brunostjohn/button-midi-thing/pics/back.jpg

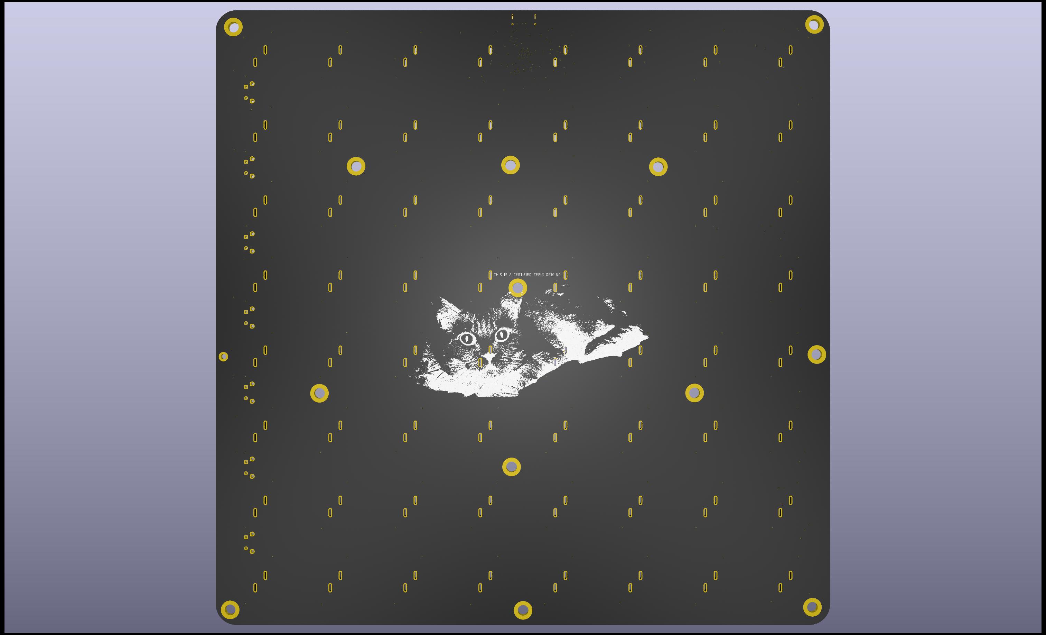
pics/back.jpg
