brunostjohn/button-midi-thing/pics/front.jpg

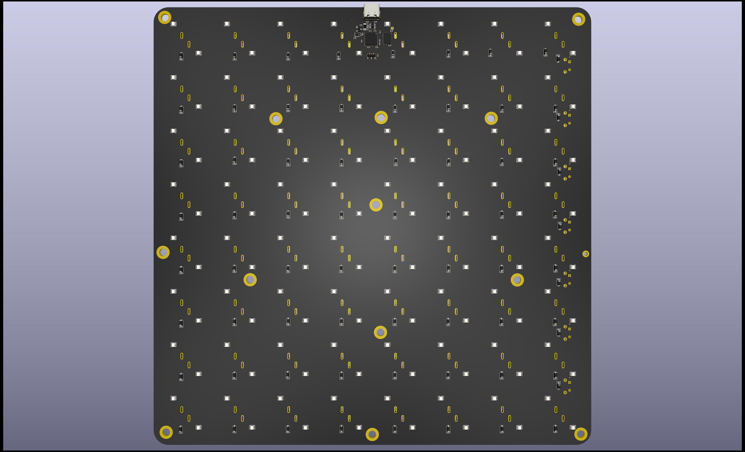
pics/front.jpg
