brunostjohn/button-midi-thing/button-thing-fw/palettes/README.md

# Palettes

These are used to generate LED colour values. All of them are made by Kaskobi and taken from the [Kaskobi website](https://kaskobi.com/palettes).
