brunostjohn/button-midi-thing/(list of files, cad)

Other CAD files:
Button MIDI Controller.step
models/WS2812B-2020--3DModel-STEP-269445.STEP
svgs/breadboardbutton v4.step
symbols_footprints/MPB06-1C33-R-SMT-TR/MPB06-1C33-R-SMT-TR.step
symbols_footprints/TS11-674-120-BK-100-RA-D/TS11-674-120-BK-100-RA-D.step
symbols_footprints/USBLC6-2SC6/USBLC6-2SC6.step
symbols_footprints/W25Q16JVZPIQ/W25Q16JVZPIQ.step
symbols_footprints/2340901-1/2340901-1.step
