brunostjohn/button-midi-thing/Button MIDI Controller.kicad_pcb

## KiCad design Button MIDI Controller.kicad_pcb (2025-05-30)

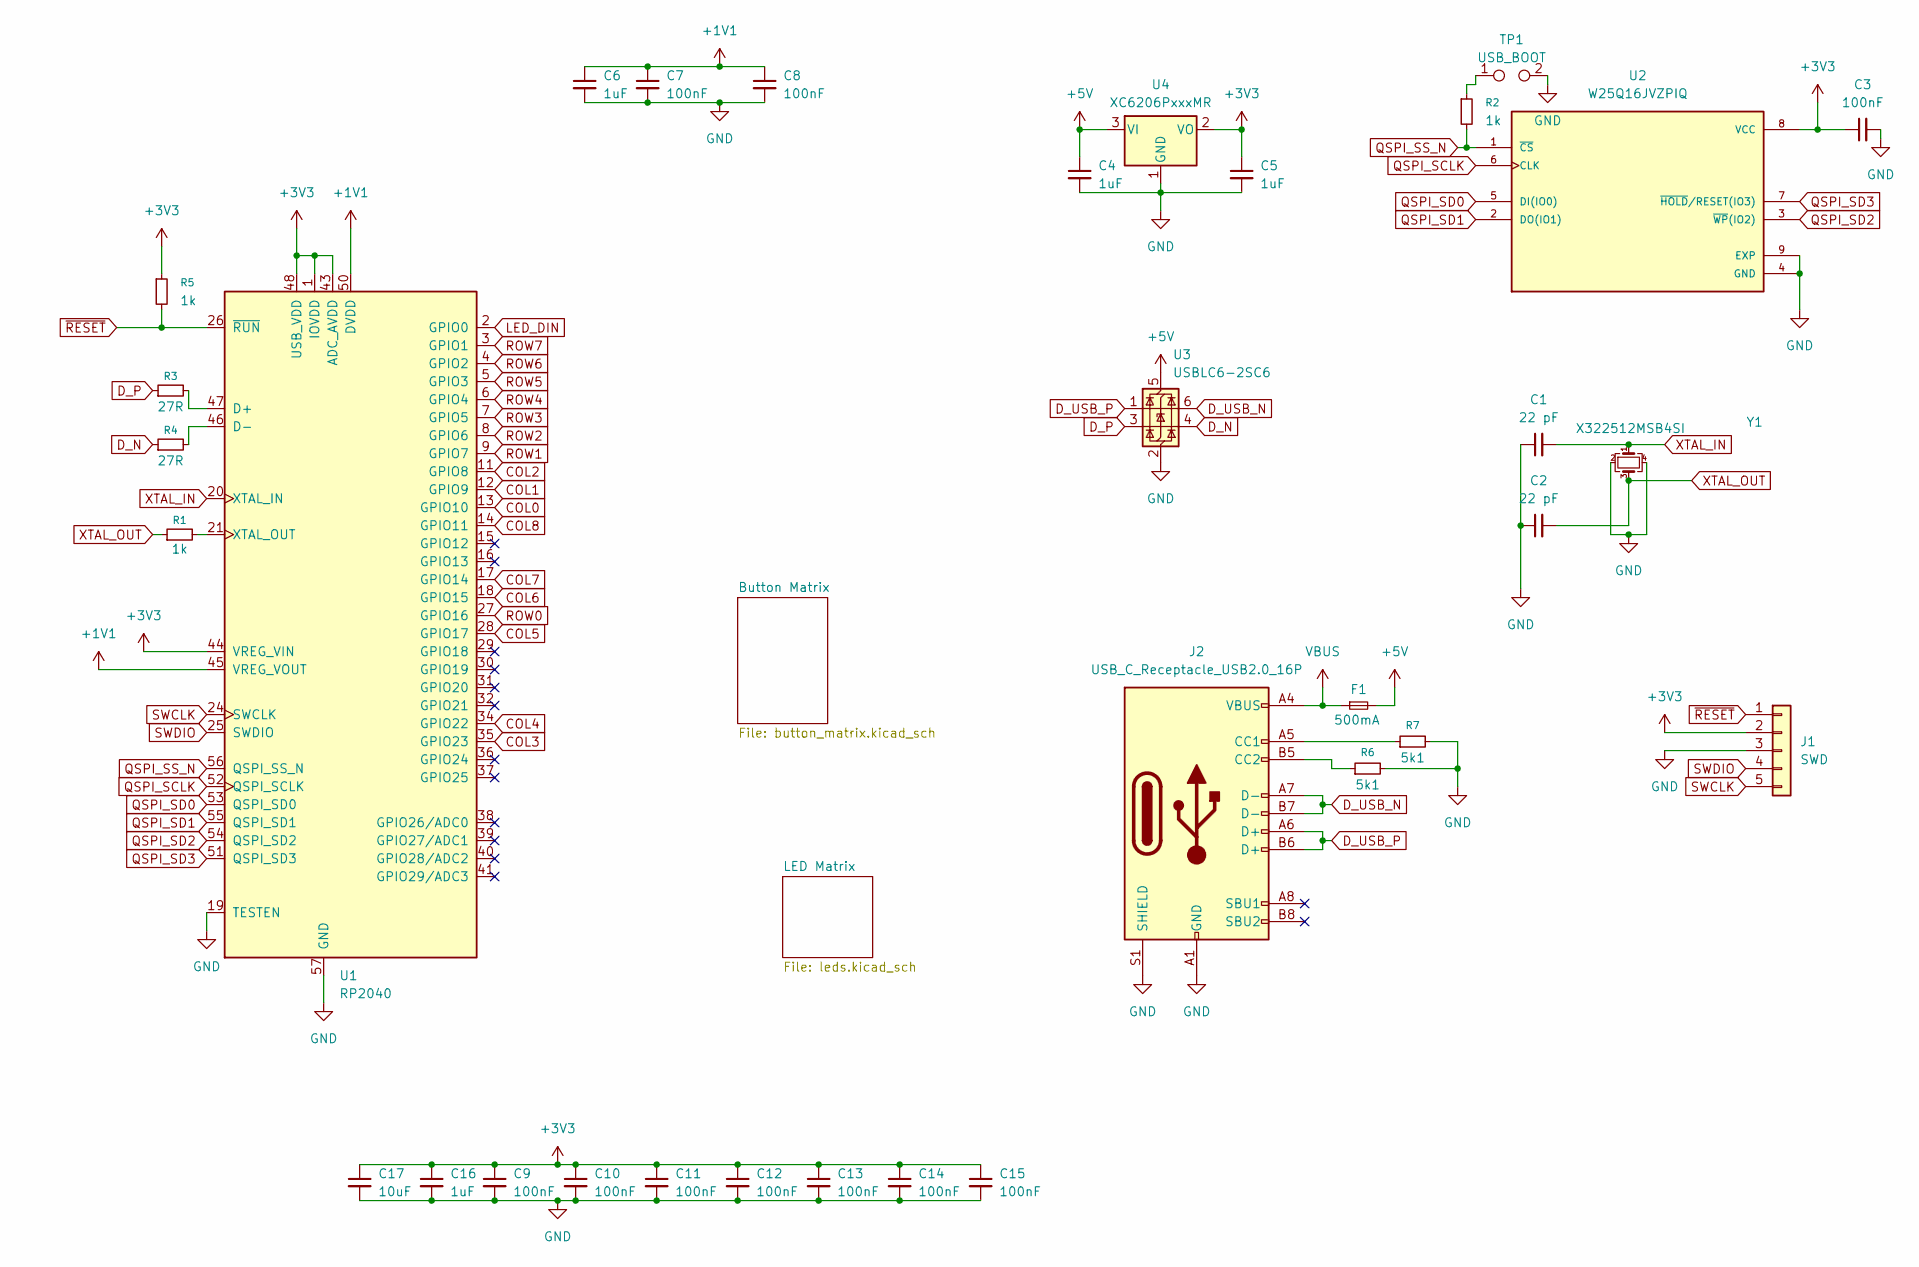
[picture p3: schematic Button MIDI Controller.kicad_sch]

Parts:
C1, C2: 22 pF; C_0402_1005Metric-notxt
C3, C7, C8, C9, C10, C11, C12, C13, C14, C15: 100nF; C_0402_1005Metric-notxt
C4, C5, C6, C16: 1uF; C_0402_1005Metric-notxt
C17: 10uF; C_0402_1005Metric-notxt
F1: 500mA; Fuse_0402_1005Metric-notxt
J1: SWD; PinHeader_1x05_P1.00mm_Vertical_SMD_Pin1Right-notxt
J2: USB_C_Receptacle_USB2.0_16P; USB_C_Receptacle_G-Switch_GT-USB-7025-notxt
R1, R2, R5: 1k; R_0402_1005Metric-notext
R3, R4: 27R; R_0402_1005Metric-notext
R6, R7: 5k1; R_0402_1005Metric-notext
TP1: USB_BOOT; TestPoint_Pad_1.0x1.0mm-notxt
U1: RP2040; RP2040-QFN-56-notext
U2: W25Q16JVZPIQ; SON127P500X600X80-9N-notxt
U3: USBLC6-2SC6; SOT-23-6-notxt
U4: XC6206PxxxMR; SOT-23-3-notxt
Y1: X322512MSB4SI; Crystal_SMD_2016-4Pin_2.0x1.6mm-notxt

Connections:
+1V1: C6.1, C7.1, C8.1, U1.23 (DVDD), U1.45 (VREG_VOUT), U1.50 (DVDD)
+3V3: C3.1, C5.1, C9.1, C10.1, C11.1, C12.1, C13.1, C14.1, C15.1, C16.1, C17.1, J1.2, R5.1, U1.1 (IOVDD), U1.10 (IOVDD), U1.22 (IOVDD), U1.33 (IOVDD), U1.42 (IOVDD), U1.43 (ADC_AVDD), U1.44 (VREG_VIN), U1.48 (USB_VDD), U1.49 (IOVDD), U2.8 (VCC), U4.2 (VO)
+5V: C4.1, F1.2, U3.5 (VBUS), U4.3 (VI); also elsewhere on the board
COL0: U1.13 (GPIO10); also elsewhere on the board
COL1: U1.12 (GPIO9); also elsewhere on the board
COL2: U1.11 (GPIO8); also elsewhere on the board
COL3: U1.35 (GPIO23); also elsewhere on the board
COL4: U1.34 (GPIO22); also elsewhere on the board
COL5: U1.28 (GPIO17); also elsewhere on the board
COL6: U1.18 (GPIO15); also elsewhere on the board
COL7: U1.17 (GPIO14); also elsewhere on the board
COL8: U1.14 (GPIO11); also elsewhere on the board
D_N: R4.1, U3.4 (I/O2)
D_P: R3.1, U3.3 (I/O2)
D_USB_N: J2.A7 (D-), J2.B7 (D-), U3.6 (I/O1)
D_USB_P: J2.A6 (D+), J2.B6 (D+), U3.1 (I/O1)
GND: C1.1, C2.1, C3.2, C4.2, C5.2, C6.2, C7.2, C8.2, C9.2, C10.2, C11.2, C12.2, C13.2, C14.2, C15.2, C16.2, C17.2, J1.3, J2.A1 (GND), J2.A12 (GND), J2.B1 (GND), J2.B12 (GND), J2.S1 (SHIELD), R6.2, R7.2, TP1.2, U1.19 (TESTEN), U1.57 (GND), U2.4 (GND), U2.9 (EXP), U3.2 (GND), U4.1 (GND), Y1.2, Y1.4; also elsewhere on the board
LED_DIN: U1.2 (GPIO0); also elsewhere on the board
unnamed: J2.A5 (CC1), R7.1
unnamed: J2.B5 (CC2), R6.1
unnamed: R2.1, TP1.1
unnamed: R3.2, U1.47 (D+)
unnamed: R4.2, U1.46 (D-)
unnamed: R1.2, U1.21 (XTAL_OUT)
QSPI_SCLK: U1.52 (QSPI_SCLK), U2.6 (CLK)
QSPI_SD0: U1.53 (QSPI_SD0), U2.5 (DI(IO0))
QSPI_SD1: U1.55 (QSPI_SD1), U2.2 (DO(IO1))
QSPI_SD2: U1.54 (QSPI_SD2), U2.3 (~WP(IO2))
QSPI_SD3: U1.51 (QSPI_SD3), U2.7 (~HOLD/RESET(IO3))
QSPI_SS_N: R2.2, U1.56 (QSPI_SS_N), U2.1 (~CS)
ROW0: U1.27 (GPIO16); also elsewhere on the board
ROW1: U1.9 (GPIO7); also elsewhere on the board
ROW2: U1.8 (GPIO6); also elsewhere on the board
ROW3: U1.7 (GPIO5); also elsewhere on the board
ROW4: U1.6 (GPIO4); also elsewhere on the board
ROW5: U1.5 (GPIO3); also elsewhere on the board
ROW6: U1.4 (GPIO2); also elsewhere on the board
ROW7: U1.3 (GPIO1); also elsewhere on the board
SWCLK: J1.5, U1.24 (SWCLK)
SWDIO: J1.4, U1.25 (SWDIO)
VBUS: F1.1, J2.A4 (VBUS), J2.A9 (VBUS), J2.B4 (VBUS), J2.B9 (VBUS)
XTAL_IN: C1.2, U1.20 (XTAL_IN), Y1.1
XTAL_OUT: C2.2, R1.1, Y1.3
~RESET: J1.1, R5.2, U1.26 (~RUN)

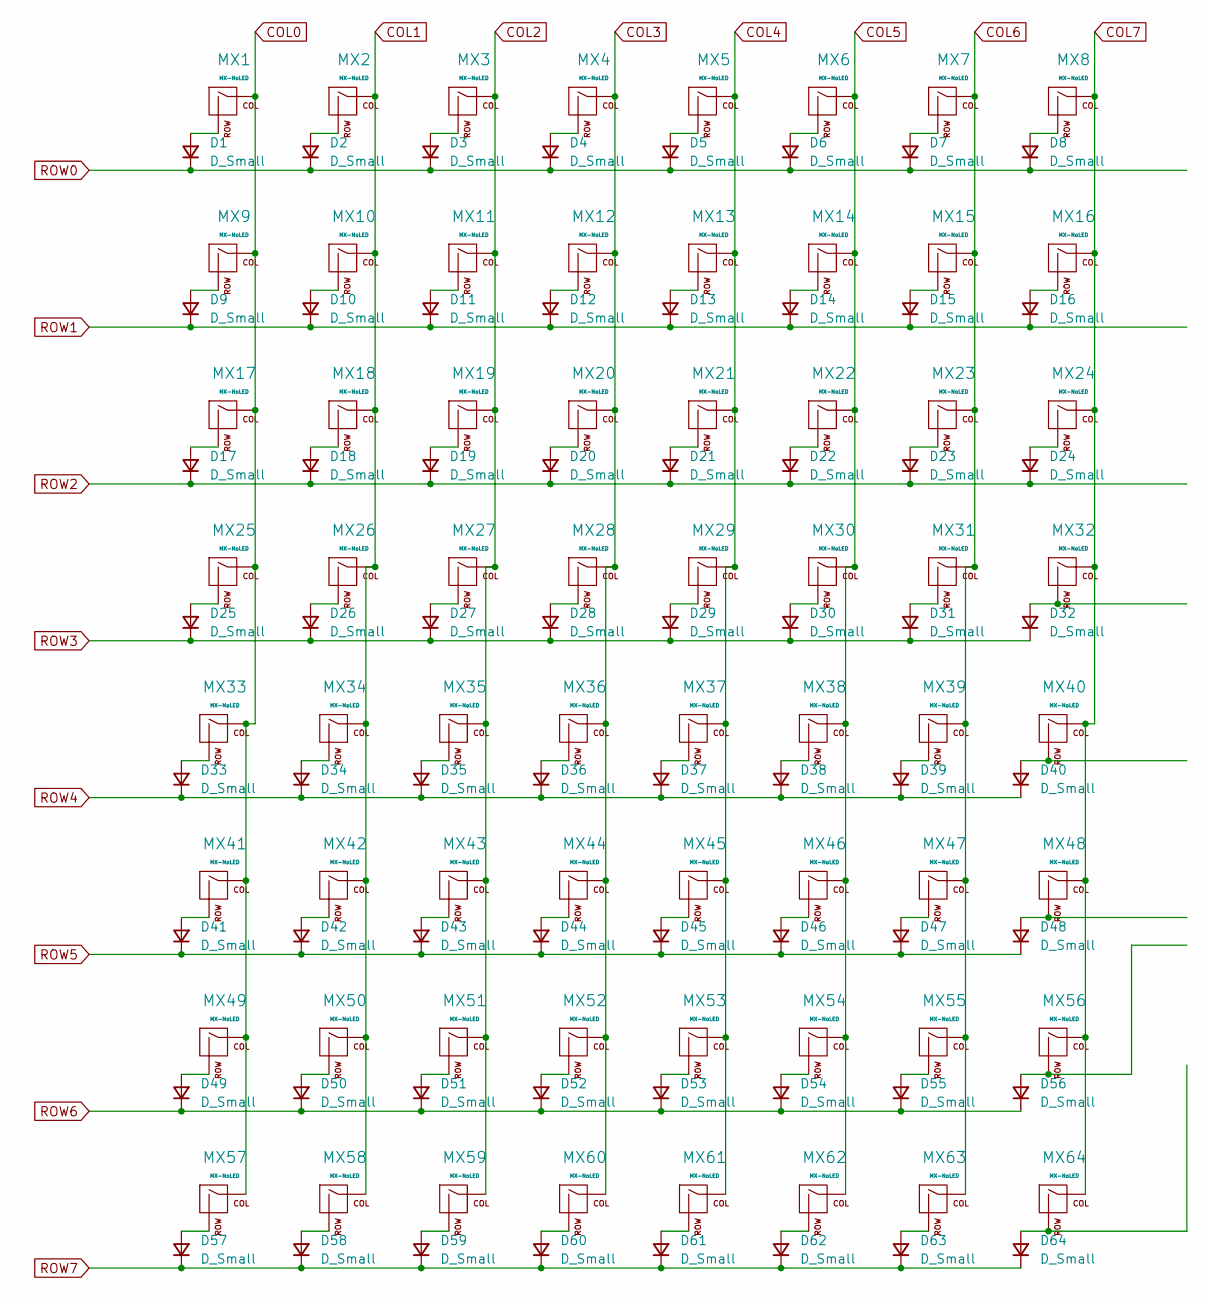
[picture p4: schematic button_matrix.kicad_sch]

Parts:
D1, D2, D3, D4, D5, D6, D7, D8, D9, D10, D11, D12, D13, D14, D15, D16, D17, D18, D19, D20, D21, D22, D23, D24, D25, D26, D27, D28, D29, D30, D31, D32, D33, D34, D35, D36, D37, D38, D39, D40, D41, D42, D43, D44, D45, D46, D47, D48, D49, D50, D51, D52, D53, D54, D55, D56, D57, D58, D59, D60, D61, D62, D63, D64: D_Small; D_0603_1608Metric_NOTXTNOTFUCKD
MX1, MX2, MX3, MX4, MX5, MX6, MX7, MX8, MX9, MX10, MX11, MX12, MX13, MX14, MX15, MX16, MX17, MX18, MX19, MX20, MX21, MX22, MX23, MX24, MX25, MX26, MX27, MX28, MX29, MX30, MX31, MX32, MX33, MX34, MX35, MX36, MX37, MX38, MX39, MX40, MX41, MX42, MX43, MX44, MX45, MX46, MX47, MX48, MX49, MX50, MX51, MX52, MX53, MX54, MX55, MX56, MX57, MX58, MX59, MX60, MX61, MX62, MX63, MX64: MX-NoLED; OBSC-30 SW-68

Connections:
COL0: MX1.1 (COL), MX9.1 (COL), MX17.1 (COL), MX25.1 (COL), MX33.1 (COL), MX41.1 (COL), MX49.1 (COL), MX57.1 (COL); also elsewhere on the board
COL1: MX2.1 (COL), MX10.1 (COL), MX18.1 (COL), MX26.1 (COL), MX34.1 (COL), MX42.1 (COL), MX50.1 (COL), MX58.1 (COL); also elsewhere on the board
COL2: MX3.1 (COL), MX11.1 (COL), MX19.1 (COL), MX27.1 (COL), MX35.1 (COL), MX43.1 (COL), MX51.1 (COL), MX59.1 (COL); also elsewhere on the board
COL3: MX4.1 (COL), MX12.1 (COL), MX20.1 (COL), MX28.1 (COL), MX36.1 (COL), MX44.1 (COL), MX52.1 (COL), MX60.1 (COL); also elsewhere on the board
COL4: MX5.1 (COL), MX13.1 (COL), MX21.1 (COL), MX29.1 (COL), MX37.1 (COL), MX45.1 (COL), MX53.1 (COL), MX61.1 (COL); also elsewhere on the board
COL5: MX6.1 (COL), MX14.1 (COL), MX22.1 (COL), MX30.1 (COL), MX38.1 (COL), MX46.1 (COL), MX54.1 (COL), MX62.1 (COL); also elsewhere on the board
COL6: MX7.1 (COL), MX15.1 (COL), MX23.1 (COL), MX31.1 (COL), MX39.1 (COL), MX47.1 (COL), MX55.1 (COL), MX63.1 (COL); also elsewhere on the board
COL7: MX8.1 (COL), MX16.1 (COL), MX24.1 (COL), MX32.1 (COL), MX40.1 (COL), MX48.1 (COL), MX56.1 (COL), MX64.1 (COL); also elsewhere on the board
unnamed: D1.2 (A), MX1.2 (ROW)
unnamed: D2.2 (A), MX2.2 (ROW)
unnamed: D3.2 (A), MX3.2 (ROW)
unnamed: D4.2 (A), MX4.2 (ROW)
unnamed: D5.2 (A), MX5.2 (ROW)
unnamed: D6.2 (A), MX6.2 (ROW)
unnamed: D7.2 (A), MX7.2 (ROW)
unnamed: D8.2 (A), MX8.2 (ROW)
unnamed: D9.2 (A), MX9.2 (ROW)
unnamed: D10.2 (A), MX10.2 (ROW)
unnamed: D11.2 (A), MX11.2 (ROW)
unnamed: D12.2 (A), MX12.2 (ROW)
unnamed: D13.2 (A), MX13.2 (ROW)
unnamed: D14.2 (A), MX14.2 (ROW)
unnamed: D15.2 (A), MX15.2 (ROW)
unnamed: D16.2 (A), MX16.2 (ROW)
unnamed: D17.2 (A), MX17.2 (ROW)
unnamed: D18.2 (A), MX18.2 (ROW)
unnamed: D19.2 (A), MX19.2 (ROW)
unnamed: D20.2 (A), MX20.2 (ROW)
unnamed: D21.2 (A), MX21.2 (ROW)
unnamed: D22.2 (A), MX22.2 (ROW)
unnamed: D23.2 (A), MX23.2 (ROW)
unnamed: D24.2 (A), MX24.2 (ROW)
unnamed: D25.2 (A), MX25.2 (ROW)
unnamed: D26.2 (A), MX26.2 (ROW)
unnamed: D27.2 (A), MX27.2 (ROW)
unnamed: D28.2 (A), MX28.2 (ROW)
unnamed: D29.2 (A), MX29.2 (ROW)
unnamed: D30.2 (A), MX30.2 (ROW)
unnamed: D31.2 (A), MX31.2 (ROW)
unnamed: D32.2 (A), MX32.2 (ROW)
unnamed: D33.2 (A), MX33.2 (ROW)
unnamed: D34.2 (A), MX34.2 (ROW)
unnamed: D35.2 (A), MX35.2 (ROW)
unnamed: D36.2 (A), MX36.2 (ROW)
unnamed: D37.2 (A), MX37.2 (ROW)
unnamed: D38.2 (A), MX38.2 (ROW)
unnamed: D39.2 (A), MX39.2 (ROW)
unnamed: D40.2 (A), MX40.2 (ROW)
unnamed: D41.2 (A), MX41.2 (ROW)
unnamed: D42.2 (A), MX42.2 (ROW)
unnamed: D43.2 (A), MX43.2 (ROW)
unnamed: D44.2 (A), MX44.2 (ROW)
unnamed: D45.2 (A), MX45.2 (ROW)
unnamed: D46.2 (A), MX46.2 (ROW)
unnamed: D47.2 (A), MX47.2 (ROW)
unnamed: D48.2 (A), MX48.2 (ROW)
unnamed: D49.2 (A), MX49.2 (ROW)
unnamed: D50.2 (A), MX50.2 (ROW)
unnamed: D51.2 (A), MX51.2 (ROW)
unnamed: D52.2 (A), MX52.2 (ROW)
unnamed: D53.2 (A), MX53.2 (ROW)
unnamed: D54.2 (A), MX54.2 (ROW)
unnamed: D55.2 (A), MX55.2 (ROW)
unnamed: D56.2 (A), MX56.2 (ROW)
unnamed: D57.2 (A), MX57.2 (ROW)
unnamed: D58.2 (A), MX58.2 (ROW)
unnamed: D59.2 (A), MX59.2 (ROW)
unnamed: D60.2 (A), MX60.2 (ROW)
unnamed: D61.2 (A), MX61.2 (ROW)
unnamed: D62.2 (A), MX62.2 (ROW)
unnamed: D63.2 (A), MX63.2 (ROW)
unnamed: D64.2 (A), MX64.2 (ROW)
ROW0: D1.1 (K), D2.1 (K), D3.1 (K), D4.1 (K), D5.1 (K), D6.1 (K), D7.1 (K), D8.1 (K); also elsewhere on the board
ROW1: D9.1 (K), D10.1 (K), D11.1 (K), D12.1 (K), D13.1 (K), D14.1 (K), D15.1 (K), D16.1 (K); also elsewhere on the board
ROW2: D17.1 (K), D18.1 (K), D19.1 (K), D20.1 (K), D21.1 (K), D22.1 (K), D23.1 (K), D24.1 (K); also elsewhere on the board
ROW3: D25.1 (K), D26.1 (K), D27.1 (K), D28.1 (K), D29.1 (K), D30.1 (K), D31.1 (K), D32.1 (K); also elsewhere on the board
ROW4: D33.1 (K), D34.1 (K), D35.1 (K), D36.1 (K), D37.1 (K), D38.1 (K), D39.1 (K), D40.1 (K); also elsewhere on the board
ROW5: D41.1 (K), D42.1 (K), D43.1 (K), D44.1 (K), D45.1 (K), D46.1 (K), D47.1 (K), D48.1 (K); also elsewhere on the board
ROW6: D49.1 (K), D50.1 (K), D51.1 (K), D52.1 (K), D53.1 (K), D54.1 (K), D55.1 (K), D56.1 (K); also elsewhere on the board
ROW7: D57.1 (K), D58.1 (K), D59.1 (K), D60.1 (K), D61.1 (K), D62.1 (K), D63.1 (K), D64.1 (K); also elsewhere on the board

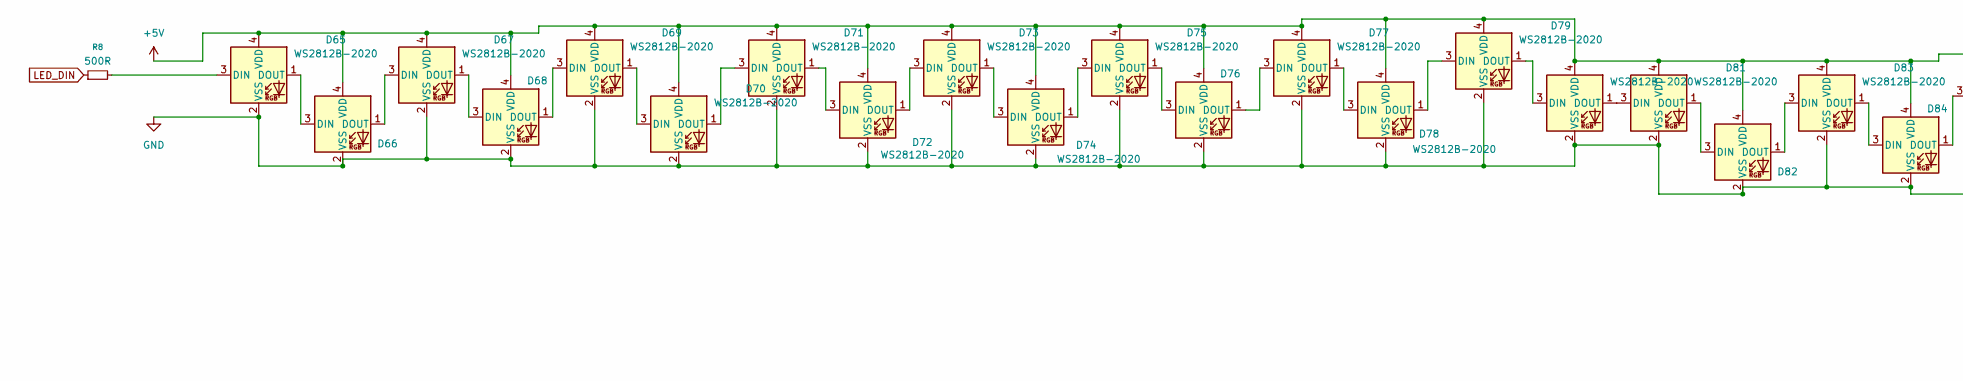
[picture p5: schematic leds.kicad_sch, part in row 1, column 1]

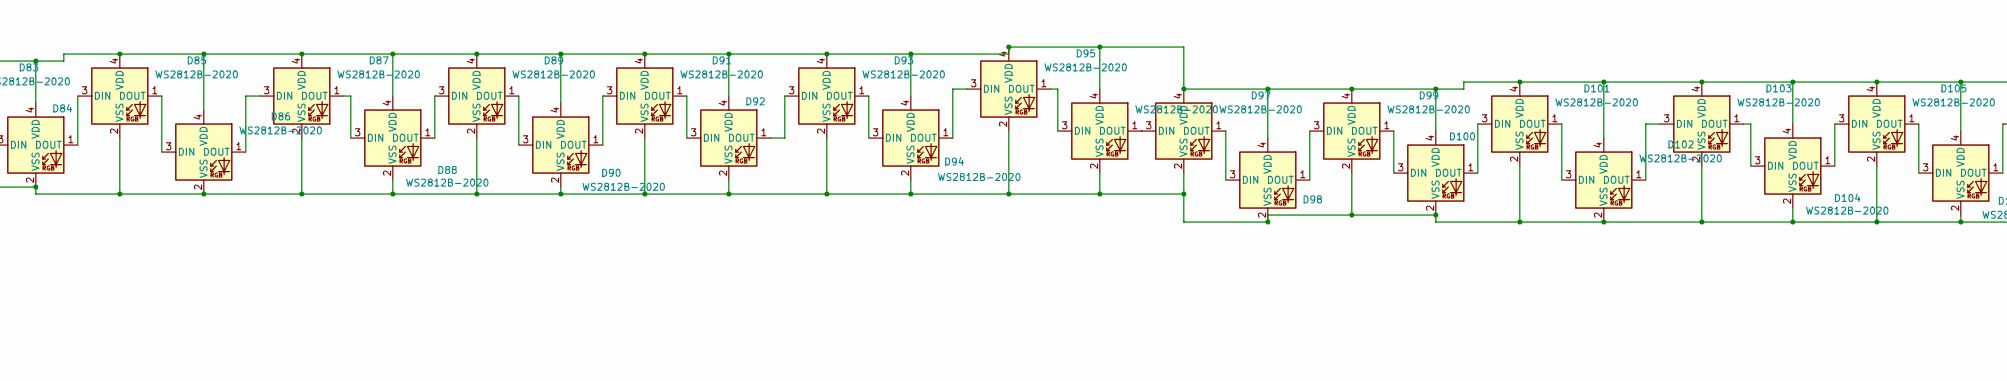
[picture p6: schematic leds.kicad_sch, part in row 1, column 2]

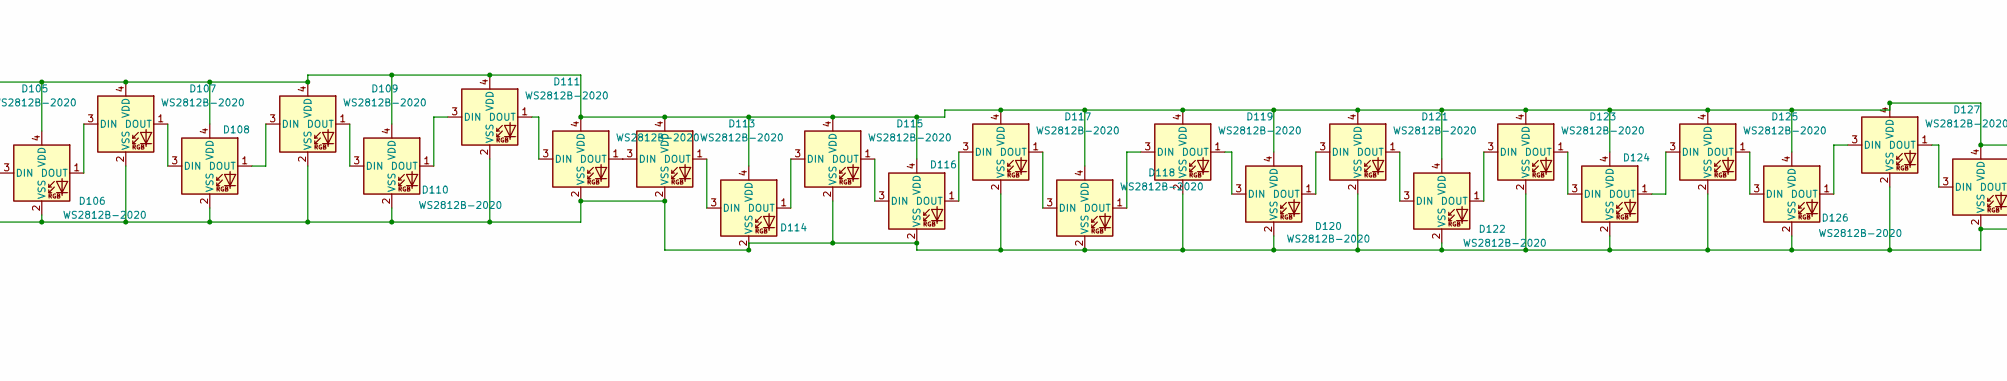
[picture p7: schematic leds.kicad_sch, part in row 1, column 3]

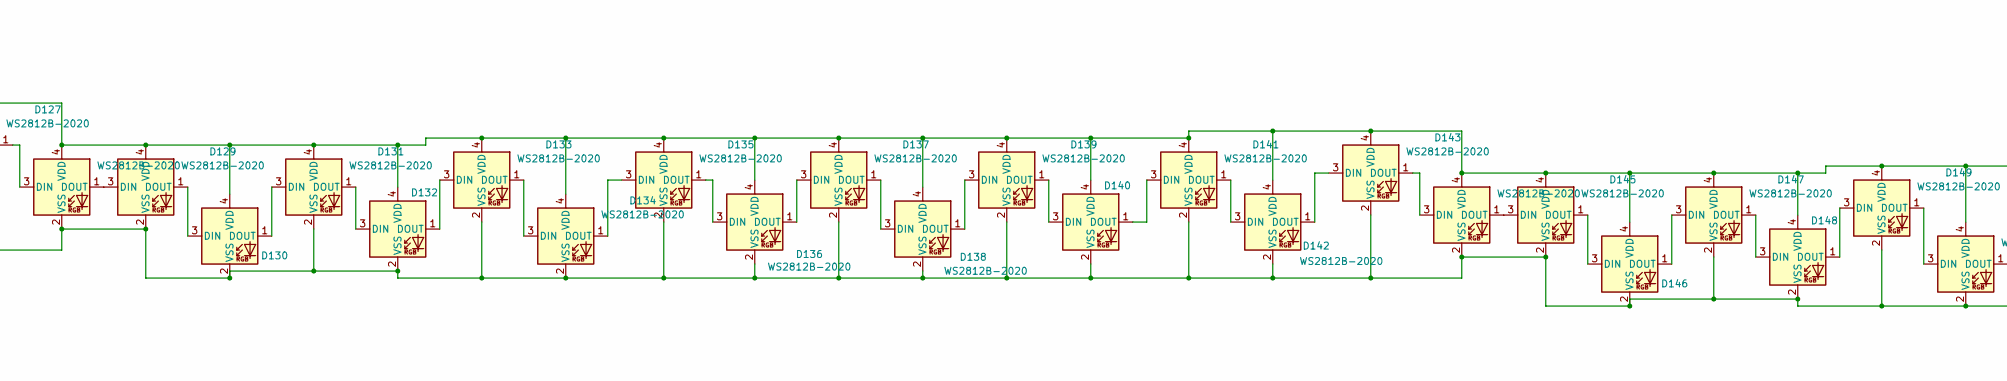
[picture p8: schematic leds.kicad_sch, part in row 1, column 4]

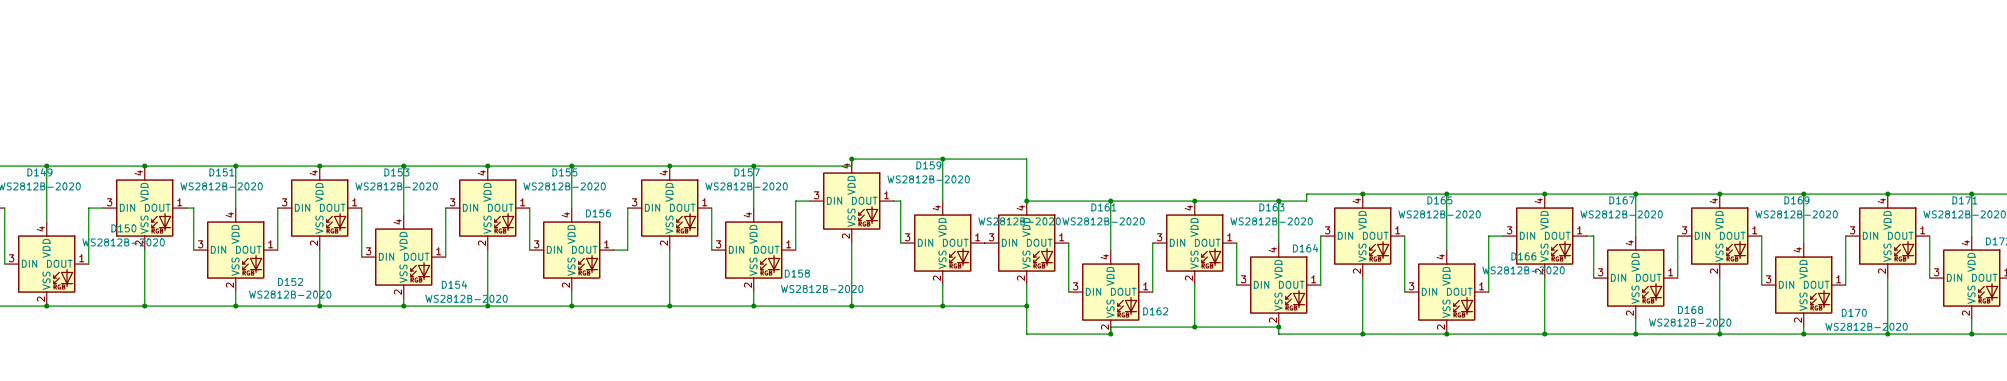
[picture p9: schematic leds.kicad_sch, part in row 1, column 5]

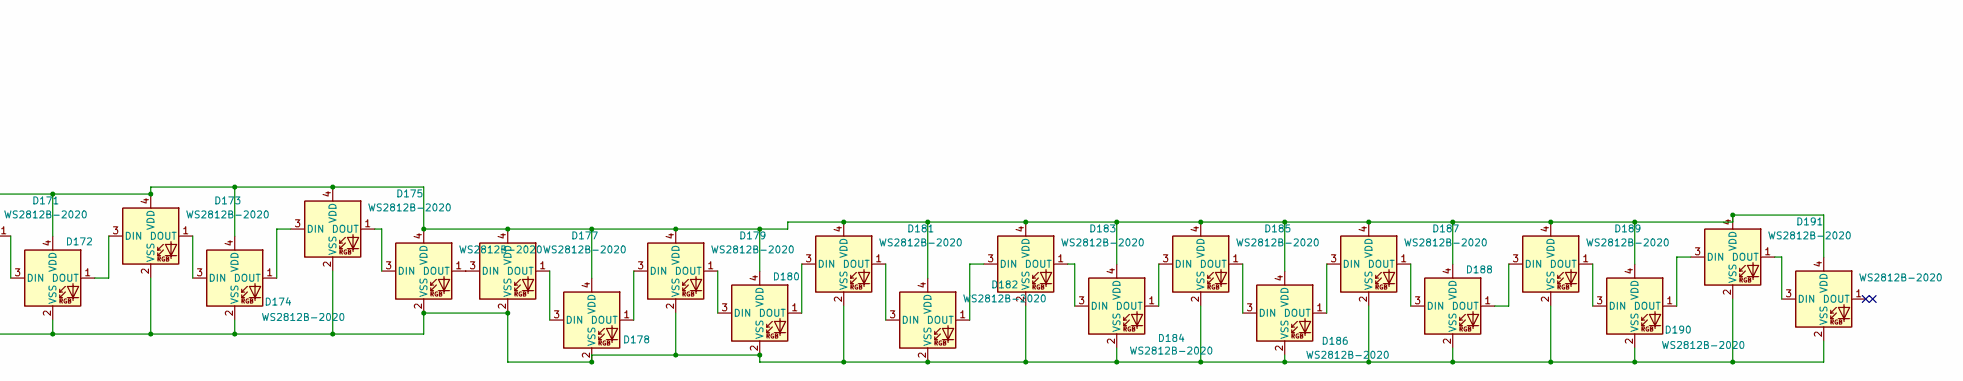
[picture p10: schematic leds.kicad_sch, part in row 1, column 6]

Parts:
D65, D66, D67, D68, D69, D70, D71, D72, D73, D74, D75, D76, D77, D78, D79, D80, D81, D82, D83, D84, D85, D86, D87, D88, D89, D90, D91, D92, D93, D94, D95, D96, D97, D98, D99, D100, D101, D102, D103, D104, D105, D106, D107, D108, D109, D110, D111, D112, D113, D114, D115, D116, D117, D118, D119, D120, D121, D122, D123, D124, D125, D126, D127, D128, D129, D130, D131, D132, D133, D134, D135, D136, D137, D138, D139, D140, D141, D142, D143, D144, D145, D146, D147, D148, D149, D150, D151, D152, D153, D154, D155, D156, D157, D158, D159, D160, D161, D162, D163, D164, D165, D166, D167, D168, D169, D170, D171, D172, D173, D174, D175, D176, D177, D178, D179, D180, D181, D182, D183, D184, D185, D186, D187, D188, D189, D190, D191, D192: WS2812B-2020; LED_WS2812B-2020_PLCC4_2.0x2.0mm-notext
R8: 500R; R_0402_1005Metric-notext

Connections:
+5V: D65.4 (VDD), D66.4 (VDD), D67.4 (VDD), D68.4 (VDD), D69.4 (VDD), D70.4 (VDD), D71.4 (VDD), D72.4 (VDD), D73.4 (VDD), D74.4 (VDD), D75.4 (VDD), D76.4 (VDD), D77.4 (VDD), D78.4 (VDD), D79.4 (VDD), D80.4 (VDD), D81.4 (VDD), D82.4 (VDD), D83.4 (VDD), D84.4 (VDD), D85.4 (VDD), D86.4 (VDD), D87.4 (VDD), D88.4 (VDD), D89.4 (VDD), D90.4 (VDD), D91.4 (VDD), D92.4 (VDD), D93.4 (VDD), D94.4 (VDD), D95.4 (VDD), D96.4 (VDD), D97.4 (VDD), D98.4 (VDD), D99.4 (VDD), D100.4 (VDD), D101.4 (VDD), D102.4 (VDD), D103.4 (VDD), D104.4 (VDD), D105.4 (VDD), D106.4 (VDD), D107.4 (VDD), D108.4 (VDD), D109.4 (VDD), D110.4 (VDD), D111.4 (VDD), D112.4 (VDD), D113.4 (VDD), D114.4 (VDD), D115.4 (VDD), D116.4 (VDD), D117.4 (VDD), D118.4 (VDD), D119.4 (VDD), D120.4 (VDD), D121.4 (VDD), D122.4 (VDD), D123.4 (VDD), D124.4 (VDD), D125.4 (VDD), D126.4 (VDD), D127.4 (VDD), D128.4 (VDD), D129.4 (VDD), D130.4 (VDD), D131.4 (VDD), D132.4 (VDD), D133.4 (VDD), D134.4 (VDD), D135.4 (VDD), D136.4 (VDD), D137.4 (VDD), D138.4 (VDD), D139.4 (VDD), D140.4 (VDD), D141.4 (VDD), D142.4 (VDD), D143.4 (VDD), D144.4 (VDD), D145.4 (VDD), D146.4 (VDD), D147.4 (VDD), D148.4 (VDD), D149.4 (VDD), D150.4 (VDD), D151.4 (VDD), D152.4 (VDD), D153.4 (VDD), D154.4 (VDD), D155.4 (VDD), D156.4 (VDD), D157.4 (VDD), D158.4 (VDD), D159.4 (VDD), D160.4 (VDD), D161.4 (VDD), D162.4 (VDD), D163.4 (VDD), D164.4 (VDD), D165.4 (VDD), D166.4 (VDD), D167.4 (VDD), D168.4 (VDD), D169.4 (VDD), D170.4 (VDD), D171.4 (VDD), D172.4 (VDD), D173.4 (VDD), D174.4 (VDD), D175.4 (VDD), D176.4 (VDD), D177.4 (VDD), D178.4 (VDD), D179.4 (VDD), D180.4 (VDD), D181.4 (VDD), D182.4 (VDD), D183.4 (VDD), D184.4 (VDD), D185.4 (VDD), D186.4 (VDD), D187.4 (VDD), D188.4 (VDD), D189.4 (VDD), D190.4 (VDD), D191.4 (VDD), D192.4 (VDD); also elsewhere on the board
GND: D65.2 (VSS), D66.2 (VSS), D67.2 (VSS), D68.2 (VSS), D69.2 (VSS), D70.2 (VSS), D71.2 (VSS), D72.2 (VSS), D73.2 (VSS), D74.2 (VSS), D75.2 (VSS), D76.2 (VSS), D77.2 (VSS), D78.2 (VSS), D79.2 (VSS), D80.2 (VSS), D81.2 (VSS), D82.2 (VSS), D83.2 (VSS), D84.2 (VSS), D85.2 (VSS), D86.2 (VSS), D87.2 (VSS), D88.2 (VSS), D89.2 (VSS), D90.2 (VSS), D91.2 (VSS), D92.2 (VSS), D93.2 (VSS), D94.2 (VSS), D95.2 (VSS), D96.2 (VSS), D97.2 (VSS), D98.2 (VSS), D99.2 (VSS), D100.2 (VSS), D101.2 (VSS), D102.2 (VSS), D103.2 (VSS), D104.2 (VSS), D105.2 (VSS), D106.2 (VSS), D107.2 (VSS), D108.2 (VSS), D109.2 (VSS), D110.2 (VSS), D111.2 (VSS), D112.2 (VSS), D113.2 (VSS), D114.2 (VSS), D115.2 (VSS), D116.2 (VSS), D117.2 (VSS), D118.2 (VSS), D119.2 (VSS), D120.2 (VSS), D121.2 (VSS), D122.2 (VSS), D123.2 (VSS), D124.2 (VSS), D125.2 (VSS), D126.2 (VSS), D127.2 (VSS), D128.2 (VSS), D129.2 (VSS), D130.2 (VSS), D131.2 (VSS), D132.2 (VSS), D133.2 (VSS), D134.2 (VSS), D135.2 (VSS), D136.2 (VSS), D137.2 (VSS), D138.2 (VSS), D139.2 (VSS), D140.2 (VSS), D141.2 (VSS), D142.2 (VSS), D143.2 (VSS), D144.2 (VSS), D145.2 (VSS), D146.2 (VSS), D147.2 (VSS), D148.2 (VSS), D149.2 (VSS), D150.2 (VSS), D151.2 (VSS), D152.2 (VSS), D153.2 (VSS), D154.2 (VSS), D155.2 (VSS), D156.2 (VSS), D157.2 (VSS), D158.2 (VSS), D159.2 (VSS), D160.2 (VSS), D161.2 (VSS), D162.2 (VSS), D163.2 (VSS), D164.2 (VSS), D165.2 (VSS), D166.2 (VSS), D167.2 (VSS), D168.2 (VSS), D169.2 (VSS), D170.2 (VSS), D171.2 (VSS), D172.2 (VSS), D173.2 (VSS), D174.2 (VSS), D175.2 (VSS), D176.2 (VSS), D177.2 (VSS), D178.2 (VSS), D179.2 (VSS), D180.2 (VSS), D181.2 (VSS), D182.2 (VSS), D183.2 (VSS), D184.2 (VSS), D185.2 (VSS), D186.2 (VSS), D187.2 (VSS), D188.2 (VSS), D189.2 (VSS), D190.2 (VSS), D191.2 (VSS), D192.2 (VSS); also elsewhere on the board
LED_DIN: R8.1; also elsewhere on the board
unnamed: D65.3 (DIN), R8.2
unnamed: D65.1 (DOUT), D66.3 (DIN)
unnamed: D66.1 (DOUT), D67.3 (DIN)
unnamed: D67.1 (DOUT), D68.3 (DIN)
unnamed: D68.1 (DOUT), D69.3 (DIN)
unnamed: D69.1 (DOUT), D70.3 (DIN)
unnamed: D70.1 (DOUT), D71.3 (DIN)
unnamed: D71.1 (DOUT), D72.3 (DIN)
unnamed: D72.1 (DOUT), D73.3 (DIN)
unnamed: D73.1 (DOUT), D74.3 (DIN)
unnamed: D74.1 (DOUT), D75.3 (DIN)
unnamed: D75.1 (DOUT), D76.3 (DIN)
unnamed: D76.1 (DOUT), D77.3 (DIN)
unnamed: D77.1 (DOUT), D78.3 (DIN)
unnamed: D78.1 (DOUT), D79.3 (DIN)
unnamed: D79.1 (DOUT), D80.3 (DIN)
unnamed: D80.1 (DOUT), D81.3 (DIN)
unnamed: D81.1 (DOUT), D82.3 (DIN)
unnamed: D82.1 (DOUT), D83.3 (DIN)
unnamed: D83.1 (DOUT), D84.3 (DIN)
unnamed: D84.1 (DOUT), D85.3 (DIN)
unnamed: D85.1 (DOUT), D86.3 (DIN)
unnamed: D86.1 (DOUT), D87.3 (DIN)
unnamed: D87.1 (DOUT), D88.3 (DIN)
unnamed: D88.1 (DOUT), D89.3 (DIN)
unnamed: D89.1 (DOUT), D90.3 (DIN)
unnamed: D90.1 (DOUT), D91.3 (DIN)
unnamed: D91.1 (DOUT), D92.3 (DIN)
unnamed: D92.1 (DOUT), D93.3 (DIN)
unnamed: D93.1 (DOUT), D94.3 (DIN)
unnamed: D94.1 (DOUT), D95.3 (DIN)
unnamed: D95.1 (DOUT), D96.3 (DIN)
unnamed: D96.1 (DOUT), D97.3 (DIN)
unnamed: D97.1 (DOUT), D98.3 (DIN)
unnamed: D98.1 (DOUT), D99.3 (DIN)
unnamed: D99.1 (DOUT), D100.3 (DIN)
unnamed: D100.1 (DOUT), D101.3 (DIN)
unnamed: D101.1 (DOUT), D102.3 (DIN)
unnamed: D102.1 (DOUT), D103.3 (DIN)
unnamed: D103.1 (DOUT), D104.3 (DIN)
unnamed: D104.1 (DOUT), D105.3 (DIN)
unnamed: D105.1 (DOUT), D106.3 (DIN)
unnamed: D106.1 (DOUT), D107.3 (DIN)
unnamed: D107.1 (DOUT), D108.3 (DIN)
unnamed: D108.1 (DOUT), D109.3 (DIN)
unnamed: D109.1 (DOUT), D110.3 (DIN)
unnamed: D110.1 (DOUT), D111.3 (DIN)
unnamed: D111.1 (DOUT), D112.3 (DIN)
unnamed: D112.1 (DOUT), D113.3 (DIN)
unnamed: D113.1 (DOUT), D114.3 (DIN)
unnamed: D114.1 (DOUT), D115.3 (DIN)
unnamed: D115.1 (DOUT), D116.3 (DIN)
unnamed: D116.1 (DOUT), D117.3 (DIN)
unnamed: D117.1 (DOUT), D118.3 (DIN)
unnamed: D118.1 (DOUT), D119.3 (DIN)
unnamed: D119.1 (DOUT), D120.3 (DIN)
unnamed: D120.1 (DOUT), D121.3 (DIN)
unnamed: D121.1 (DOUT), D122.3 (DIN)
unnamed: D122.1 (DOUT), D123.3 (DIN)
unnamed: D123.1 (DOUT), D124.3 (DIN)
unnamed: D124.1 (DOUT), D125.3 (DIN)
unnamed: D125.1 (DOUT), D126.3 (DIN)
unnamed: D126.1 (DOUT), D127.3 (DIN)
unnamed: D127.1 (DOUT), D128.3 (DIN)
unnamed: D128.1 (DOUT), D129.3 (DIN)
unnamed: D129.1 (DOUT), D130.3 (DIN)
unnamed: D130.1 (DOUT), D131.3 (DIN)
unnamed: D131.1 (DOUT), D132.3 (DIN)
unnamed: D132.1 (DOUT), D133.3 (DIN)
unnamed: D133.1 (DOUT), D134.3 (DIN)
unnamed: D134.1 (DOUT), D135.3 (DIN)
unnamed: D135.1 (DOUT), D136.3 (DIN)
unnamed: D136.1 (DOUT), D137.3 (DIN)
unnamed: D137.1 (DOUT), D138.3 (DIN)
unnamed: D138.1 (DOUT), D139.3 (DIN)
unnamed: D139.1 (DOUT), D140.3 (DIN)
unnamed: D140.1 (DOUT), D141.3 (DIN)
unnamed: D141.1 (DOUT), D142.3 (DIN)
unnamed: D142.1 (DOUT), D143.3 (DIN)
unnamed: D143.1 (DOUT), D144.3 (DIN)
unnamed: D144.1 (DOUT), D145.3 (DIN)
unnamed: D145.1 (DOUT), D146.3 (DIN)
unnamed: D146.1 (DOUT), D147.3 (DIN)
unnamed: D147.1 (DOUT), D148.3 (DIN)
unnamed: D148.1 (DOUT), D149.3 (DIN)
unnamed: D149.1 (DOUT), D150.3 (DIN)
unnamed: D150.1 (DOUT), D151.3 (DIN)
unnamed: D151.1 (DOUT), D152.3 (DIN)
unnamed: D152.1 (DOUT), D153.3 (DIN)
unnamed: D153.1 (DOUT), D154.3 (DIN)
unnamed: D154.1 (DOUT), D155.3 (DIN)
unnamed: D155.1 (DOUT), D156.3 (DIN)
unnamed: D156.1 (DOUT), D157.3 (DIN)
unnamed: D157.1 (DOUT), D158.3 (DIN)
unnamed: D158.1 (DOUT), D159.3 (DIN)
unnamed: D159.1 (DOUT), D160.3 (DIN)
unnamed: D160.1 (DOUT), D161.3 (DIN)
unnamed: D161.1 (DOUT), D162.3 (DIN)
unnamed: D162.1 (DOUT), D163.3 (DIN)
unnamed: D163.1 (DOUT), D164.3 (DIN)
unnamed: D164.1 (DOUT), D165.3 (DIN)
unnamed: D165.1 (DOUT), D166.3 (DIN)
unnamed: D166.1 (DOUT), D167.3 (DIN)
unnamed: D167.1 (DOUT), D168.3 (DIN)
unnamed: D168.1 (DOUT), D169.3 (DIN)
unnamed: D169.1 (DOUT), D170.3 (DIN)
unnamed: D170.1 (DOUT), D171.3 (DIN)
unnamed: D171.1 (DOUT), D172.3 (DIN)
unnamed: D172.1 (DOUT), D173.3 (DIN)
unnamed: D173.1 (DOUT), D174.3 (DIN)
unnamed: D174.1 (DOUT), D175.3 (DIN)
unnamed: D175.1 (DOUT), D176.3 (DIN)
unnamed: D176.1 (DOUT), D177.3 (DIN)
unnamed: D177.1 (DOUT), D178.3 (DIN)
unnamed: D178.1 (DOUT), D179.3 (DIN)
unnamed: D179.1 (DOUT), D180.3 (DIN)
unnamed: D180.1 (DOUT), D181.3 (DIN)
unnamed: D181.1 (DOUT), D182.3 (DIN)
unnamed: D182.1 (DOUT), D183.3 (DIN)
unnamed: D183.1 (DOUT), D184.3 (DIN)
unnamed: D184.1 (DOUT), D185.3 (DIN)
unnamed: D185.1 (DOUT), D186.3 (DIN)
unnamed: D186.1 (DOUT), D187.3 (DIN)
unnamed: D187.1 (DOUT), D188.3 (DIN)
unnamed: D188.1 (DOUT), D189.3 (DIN)
unnamed: D189.1 (DOUT), D190.3 (DIN)
unnamed: D190.1 (DOUT), D191.3 (DIN)
unnamed: D191.1 (DOUT), D192.3 (DIN)

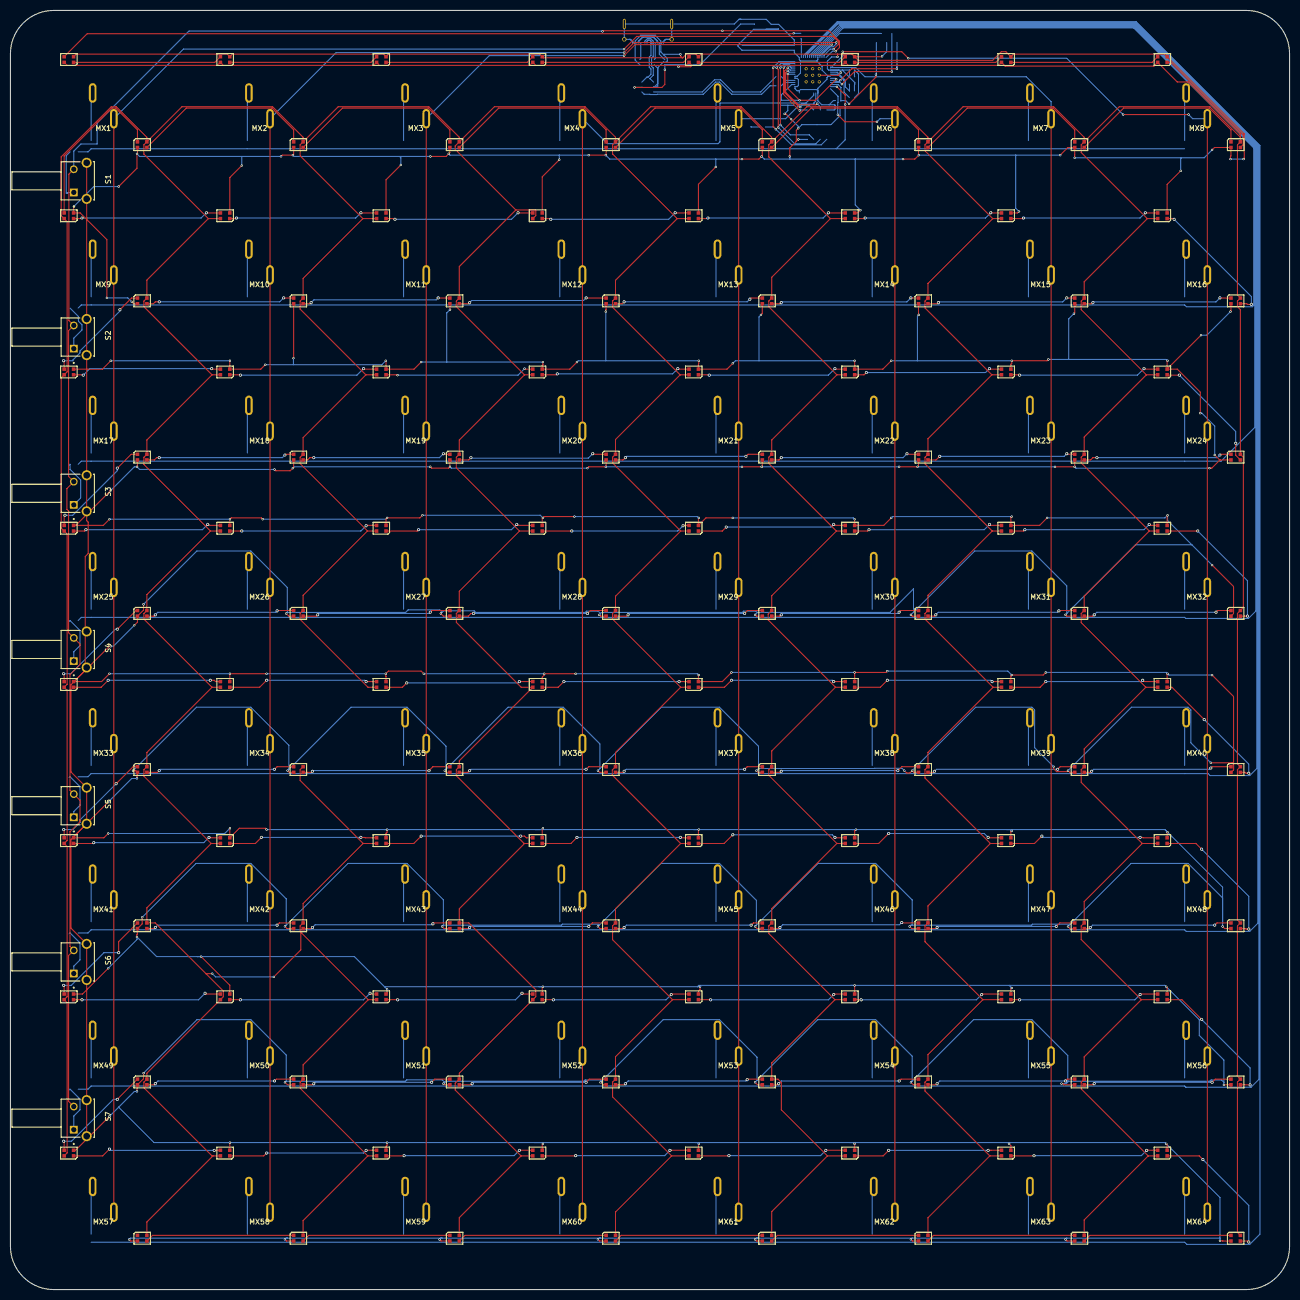
[picture p11: board Button MIDI Controller.kicad_pcb from above]

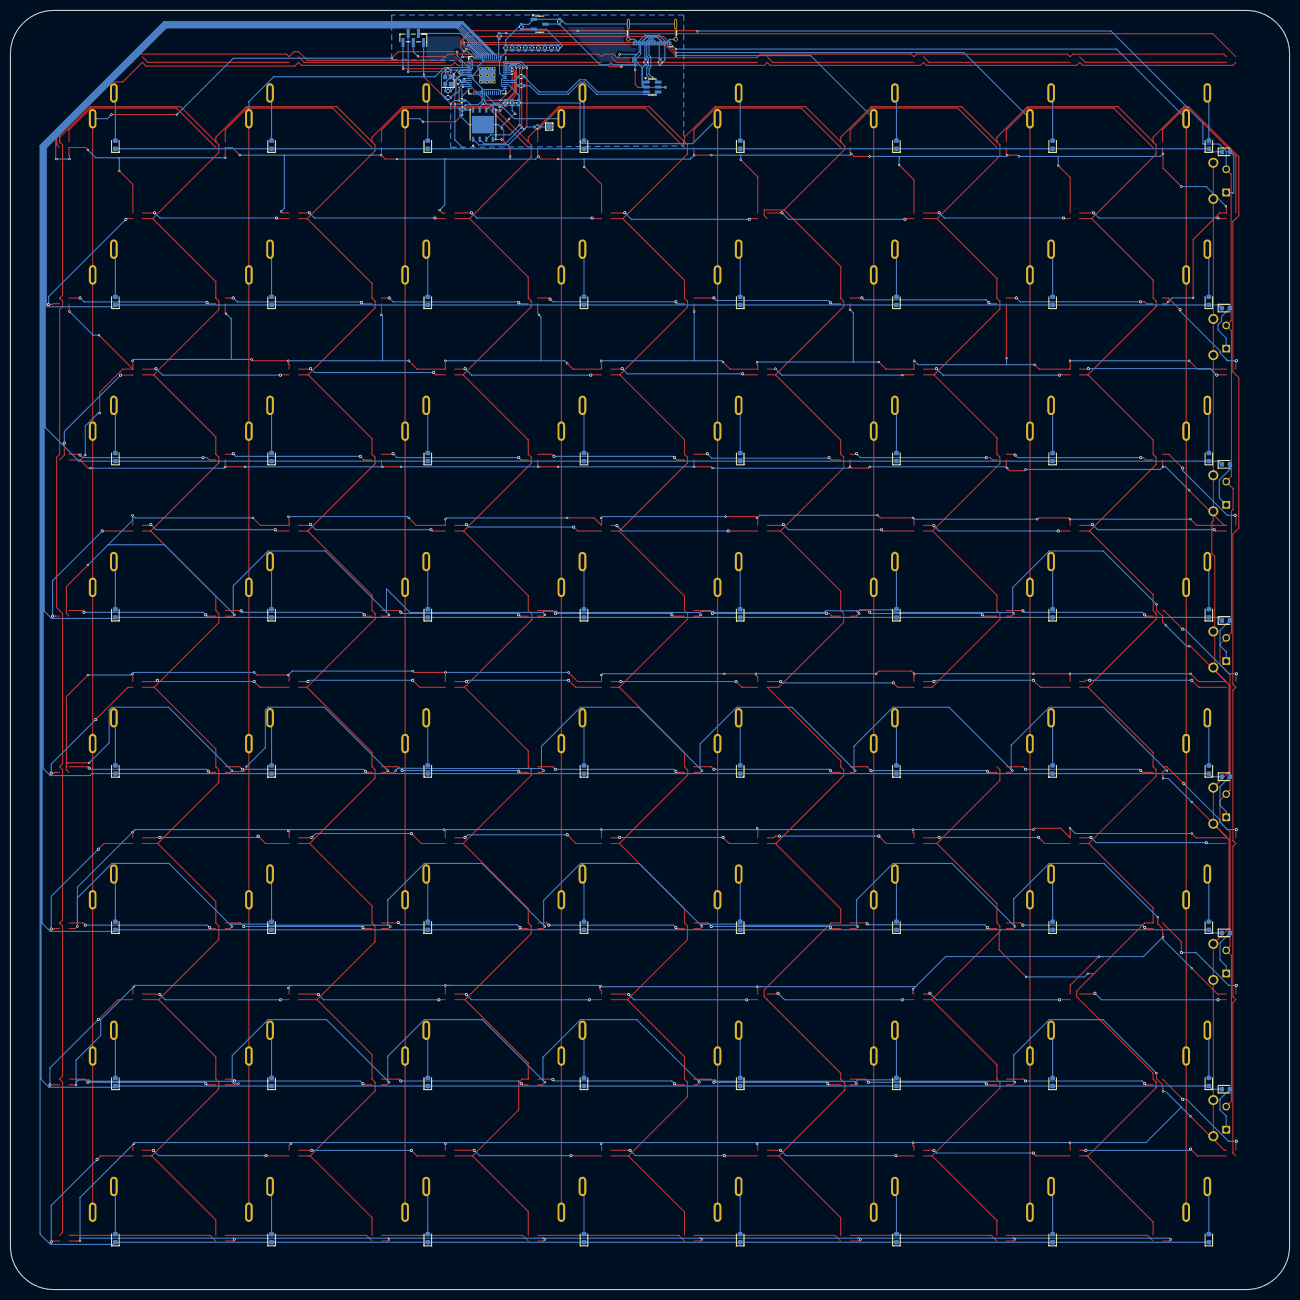
[picture p12: board Button MIDI Controller.kicad_pcb from below]

Board: 2 copper layers, 248.1 x 248.1 mm, 304 parts (105 on the bottom side), 243 nets.

Other parts of the board:
D193, D194, D195, D196, D197, D198, D199: D_Small; D_0603_1608Metric-notxt
S1, S2, S3, S4, S5, S6, S7: TS11-674-120-BK-100-RA-D; SW_TS11-674-120-BK-100-RA-D

Their connections:
COL8: S1.2, S2.2, S3.2, S4.2, S5.2, S6.2, S7.2; also elsewhere on the board
GND: S1.3 (GND), S1.4 (GND), S2.3 (GND), S2.4 (GND), S3.3 (GND), S3.4 (GND), S4.3 (GND), S4.4 (GND), S5.3 (GND), S5.4 (GND), S6.3 (GND), S6.4 (GND), S7.3 (GND), S7.4 (GND); also elsewhere on the board
unnamed: D193.2 (A), S1.1
unnamed: D194.2 (A), S2.1
unnamed: D195.2 (A), S3.1
unnamed: D196.2 (A), S4.1
unnamed: D197.2 (A), S5.1
unnamed: D198.2 (A), S6.1
unnamed: D199.2 (A), S7.1
ROW0: D193.1 (K); also elsewhere on the board
ROW1: D194.1 (K); also elsewhere on the board
ROW2: D195.1 (K); also elsewhere on the board
ROW3: D196.1 (K); also elsewhere on the board
ROW4: D197.1 (K); also elsewhere on the board
ROW5: D198.1 (K); also elsewhere on the board
ROW6: D199.1 (K); also elsewhere on the board
