brunostjohn/button-midi-thing/button-thing-fw/src/colour.rs

pub const fn velocity_to_rgb(velocity: u8) -> (u8, u8, u8) {
    debug_assert!(velocity <= 127, "velocity must be less than 127");

    match velocity {
        0 => (0, 0, 0),
        1 => (7, 7, 7),
        2 => (31, 31, 31),
        3 => (63, 63, 63),
        4 => (63, 18, 18),
        5 => (63, 0, 0),
        6 => (21, 0, 0),
        7 => (6, 0, 0),
        8 => (63, 46, 26),
        9 => (63, 20, 0),
        10 => (21, 7, 0),
        11 => (9, 6, 0),
        12 => (63, 63, 18),
        13 => (63, 63, 0),
        14 => (21, 21, 0),
        15 => (6, 6, 0),
        16 => (33, 63, 18),
        17 => (20, 63, 0),
        18 => (7, 21, 0),
        19 => (4, 10, 0),
        20 => (18, 63, 18),
        21 => (0, 63, 0),
        22 => (0, 21, 0),
        23 => (0, 6, 0),
        24 => (18, 63, 23),
        25 => (0, 63, 6),
        26 => (0, 21, 3),
        27 => (0, 6, 0),
        28 => (18, 63, 33),
        29 => (0, 63, 21),
        30 => (0, 21, 7),
        31 => (0, 7, 4),
        32 => (18, 63, 45),
        33 => (0, 63, 37),
        34 => (0, 21, 13),
        35 => (0, 6, 4),
        36 => (18, 48, 63),
        37 => (0, 41, 63),
        38 => (0, 16, 20),
        39 => (0, 3, 6),
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
        _ => unreachable!(),
    }
}
