brunostjohn/button-midi-thing/(commit log)

2025-05-30 updatres again
    [Button MIDI Controller-B_Cu.gbr, Button MIDI Controller-B_Mask.gbr, Button MIDI Controller-B_Paste.gbr, Button MIDI Controller-B_Silkscreen.gbr, Button MIDI Controller-Edge_Cuts.gbr, Button MIDI Controller-F_Cu.gbr, Button MIDI Controller-F_Mask.gbr, Button MIDI Controller-F_Paste.gbr]
2025-05-30 add zefir to da mix
    [button_matrix.kicad_sch]
2025-05-31 update shit
    [Button MIDI Controller-B_Cu.gbr, Button MIDI Controller-B_Mask.gbr, Button MIDI Controller-B_Paste.gbr, Button MIDI Controller-B_Silkscreen.gbr, Button MIDI Controller-Edge_Cuts.gbr, Button MIDI Controller-F_Cu.gbr, Button MIDI Controller-F_Mask.gbr, Button MIDI Controller-F_Paste.gbr]
2025-05-31 move gerbers
    [Button MIDI Controller-B_Cu.gbr, Button MIDI Controller-B_Mask.gbr, Button MIDI Controller-B_Paste.gbr, Button MIDI Controller-B_Silkscreen.gbr, Button MIDI Controller-Edge_Cuts.gbr, Button MIDI Controller-F_Cu.gbr, Button MIDI Controller-F_Mask.gbr, Button MIDI Controller-F_Paste.gbr]
2025-05-31 yeah have some updates my g
    [Button MIDI Controller-B_Cu.gbr, Button MIDI Controller-B_Mask.gbr, Button MIDI Controller-B_Paste.gbr, Button MIDI Controller-B_Silkscreen.gbr, Button MIDI Controller-Edge_Cuts.gbr, Button MIDI Controller-F_Cu.gbr, Button MIDI Controller-F_Mask.gbr, Button MIDI Controller-F_Paste.gbr]
2025-05-31 boardstar updates & me ruining it
    [Button MIDI Controller.kicad_sch]
2025-06-01 readme and other updates
    [Button MIDI Controller-B_Cu.gbr, Button MIDI Controller-B_Mask.gbr, Button MIDI Controller-B_Paste.gbr, Button MIDI Controller-B_Silkscreen.gbr, Button MIDI Controller-Edge_Cuts.gbr, Button MIDI Controller-F_Cu.gbr, Button MIDI Controller-F_Mask.gbr, Button MIDI Controller-F_Paste.gbr]
2025-06-01 lfs time
    [2340901-1.step, MPB06-1C33-R-SMT-TR.step, TS11-674-120-BK-100-RA-D.step, USBLC6-2SC6.step, W25Q16JVZPIQ.step, WS2812B-2020--3DModel-STEP-269445.STEP]
2025-06-02 some modifications i forgor
    [Button MIDI Controller-B_Cu.gbr, Button MIDI Controller-B_Mask.gbr, Button MIDI Controller-B_Paste.gbr, Button MIDI Controller-B_Silkscreen.gbr, Button MIDI Controller-Edge_Cuts.gbr, Button MIDI Controller-F_Cu.gbr, Button MIDI Controller-F_Mask.gbr, Button MIDI Controller-F_Paste.gbr]
